j0415j/piscsi/hw/daisy_chain_board/daisy_chain_board.kicad_pcb

## KiCad design hw/daisy_chain_board/daisy_chain_board.kicad_pcb (2022-09-09)

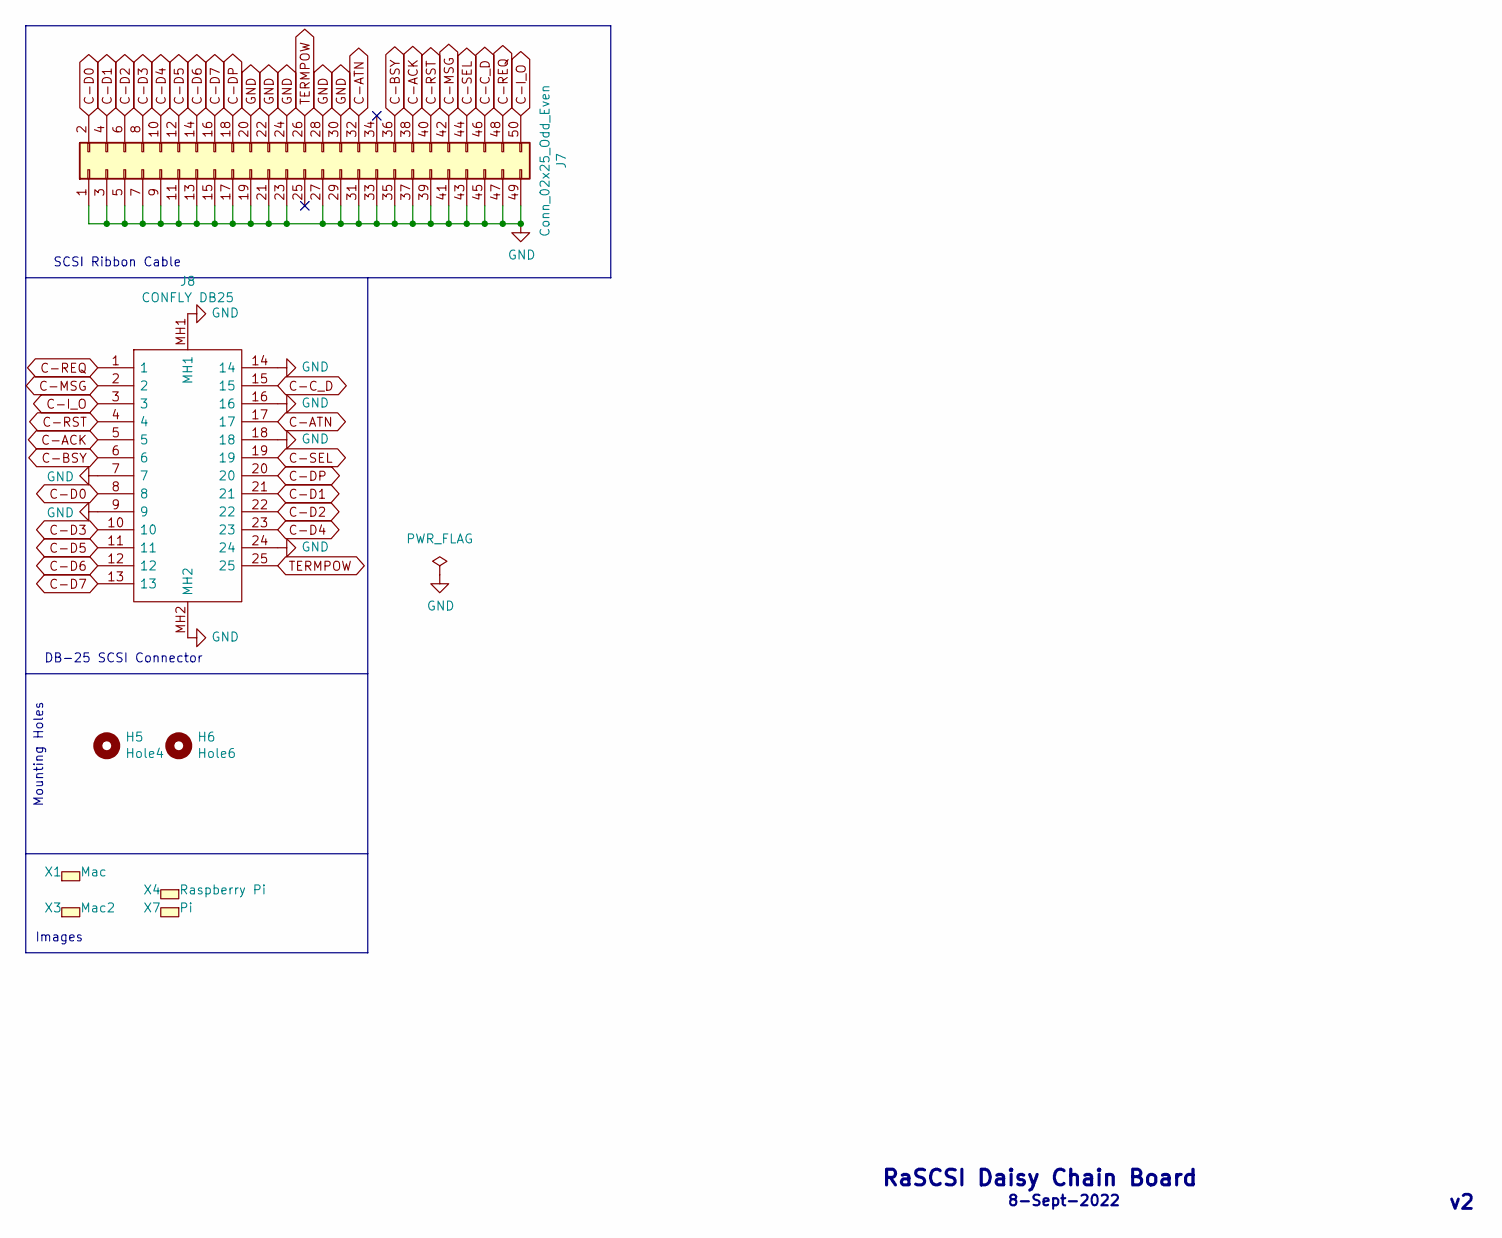
[picture p1: schematic daisy_chain_board.kicad_sch]

Parts:
H5: Hole4; MountingHole_2.7mm
H6: Hole6; MountingHole_2.7mm
J7: Conn_02x25_Odd_Even; PinHeader_2x25_P2.54mm_Vertical; LCSC C40024
J8: CONFLY DB25; L717SDB25PA4CH4F; Mouser Part Number 523-L717SDB25PA4CH4F
X1: Mac; mac_happy_small
X3: Mac2; mac_happy_small
X4: Raspberry Pi; pi_logo
X7: Pi; pi_logo

Connections:
C-ACK: J7.38, J8.5
C-ATN: J7.32, J8.17
C-BSY: J7.36, J8.6
C-C_D: J7.46, J8.15
C-D0: J7.2, J8.8
C-D1: J7.4, J8.21
C-D2: J7.6, J8.22
C-D3: J7.8, J8.10
C-D4: J7.10, J8.23
C-D5: J7.12, J8.11
C-D6: J7.14, J8.12
C-D7: J7.16, J8.13
C-DP: J7.18, J8.20
C-I_O: J7.50, J8.3
C-MSG: J7.42, J8.2
C-REQ: J7.48, J8.1
C-RST: J7.40, J8.4
C-SEL: J7.44, J8.19
GND: J7.1, J7.3, J7.5, J7.7, J7.9, J7.11, J7.13, J7.15, J7.17, J7.19, J7.20, J7.21, J7.22, J7.23, J7.24, J7.27, J7.28, J7.29, J7.30, J7.31, J7.33, J7.35, J7.37, J7.39, J7.41, J7.43, J7.45, J7.47, J7.49, J8.7, J8.9, J8.14, J8.16, J8.18, J8.24, J8.MH1, J8.MH2
TERMPOW: J7.26, J8.25

Notes on the sheet:
DB-25 SCSI Connector
Images
8-Sept-2022
RaSCSI Daisy Chain Board
Mounting Holes
SCSI Ribbon Cable

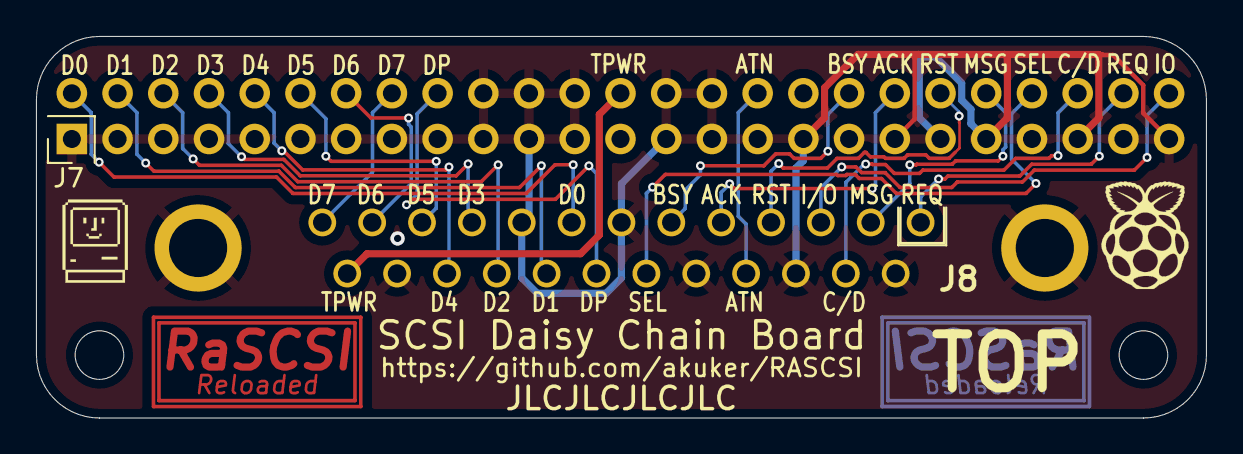
[picture p2: board daisy_chain_board.kicad_pcb from above]

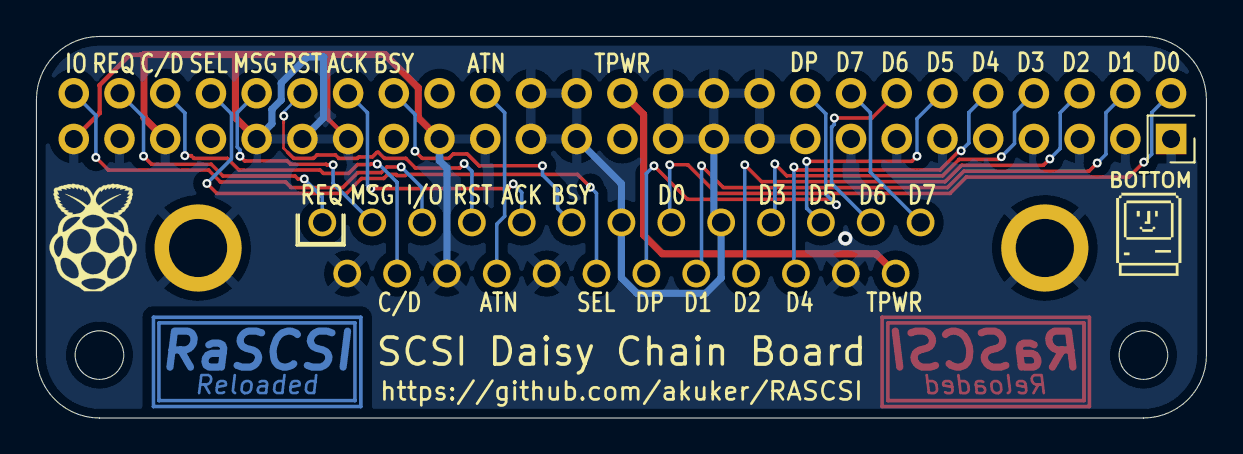
[picture p3: board daisy_chain_board.kicad_pcb from below]

Board: 2 copper layers, 65.0 x 21.2 mm, 8 parts (3 on the bottom side), 20 nets.
