j0415j/piscsi/(commit log)

2022-07-20 Updated with 74LVT245 - as ordered
    [Connectors.kicad_sch, USB_Conn.kicad_sch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]
2022-08-06 Restore version 2.6a board. Move 2.6c to 2.7
    [Connectors.kicad_sch, USB_Conn.kicad_sch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]
2022-08-06 as-ordered v2.7a
    [Connectors.kicad_sch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]
2022-08-10 Updated to say RaSCSI Reloaded and silkscreen cleanup
    [daisy_chain_board-B_Mask.gbr, daisy_chain_board-B_SilkS.gbr, daisy_chain_board-Bottom.gbr, daisy_chain_board-Edge_Cuts.gbr, daisy_chain_board-F_Mask.gbr, daisy_chain_board-F_SilkS.gbr, daisy_chain_board-Top.gbr, daisy_chain_board-job.gbrjob]
2022-09-04 Added pin labels on top side
    [daisy_chain_board-B_Mask.gbs, daisy_chain_board-B_Paste.gbp, daisy_chain_board-B_Silkscreen.gbo, daisy_chain_board-Bottom.gbl, daisy_chain_board-Edge_Cuts.gm1, daisy_chain_board-F_Mask.gts, daisy_chain_board-F_Paste.gtp, daisy_chain_board-F_Silkscreen.gto]
2022-09-04 re-add 3d shapes
    [daisy_chain_board-B_Mask.gbs, daisy_chain_board-B_Paste.gbp, daisy_chain_board-B_Silkscreen.gbo, daisy_chain_board-Bottom.gbl, daisy_chain_board-Edge_Cuts.gm1, daisy_chain_board-F_Mask.gts, daisy_chain_board-F_Paste.gtp, daisy_chain_board-F_Silkscreen.gto]
2022-09-09 As-ordered version
    [daisy_chain_board-B_Mask.gbs, daisy_chain_board-B_Paste.gbp, daisy_chain_board-B_Silkscreen.gbo, daisy_chain_board-Bottom.gbl, daisy_chain_board-Edge_Cuts.gm1, daisy_chain_board-F_Mask.gts, daisy_chain_board-F_Paste.gtp, daisy_chain_board-F_Silkscreen.gto]
2022-09-09 as ordered
    [Connectors.kicad_sch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]
